Michael-Ainsworth/Teleoperated-Robotic-Arm/3D_Models/Mold-topThermistor.stl

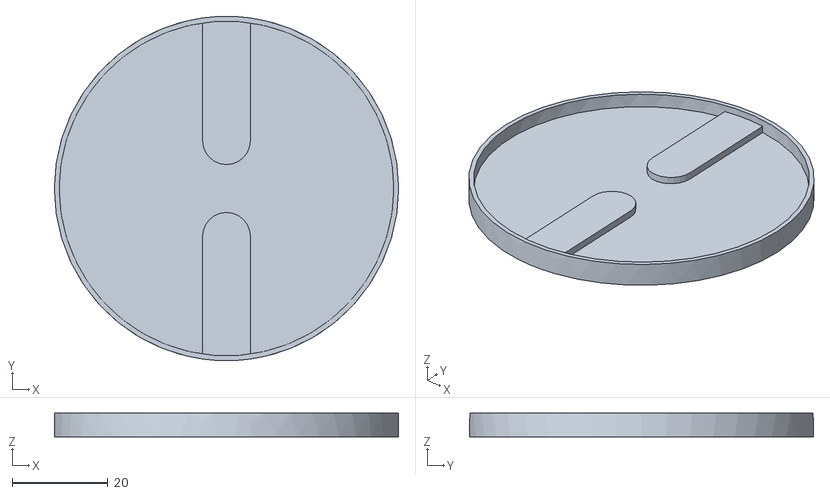
[picture p33: CAD file, 2020-02-25]
3D_Models/Mold-topThermistor.stl
72.0 x 71.9 x 5.00
