Michael-Ainsworth/Teleoperated-Robotic-Arm/3D_Models/Mold-FingerCap.stl

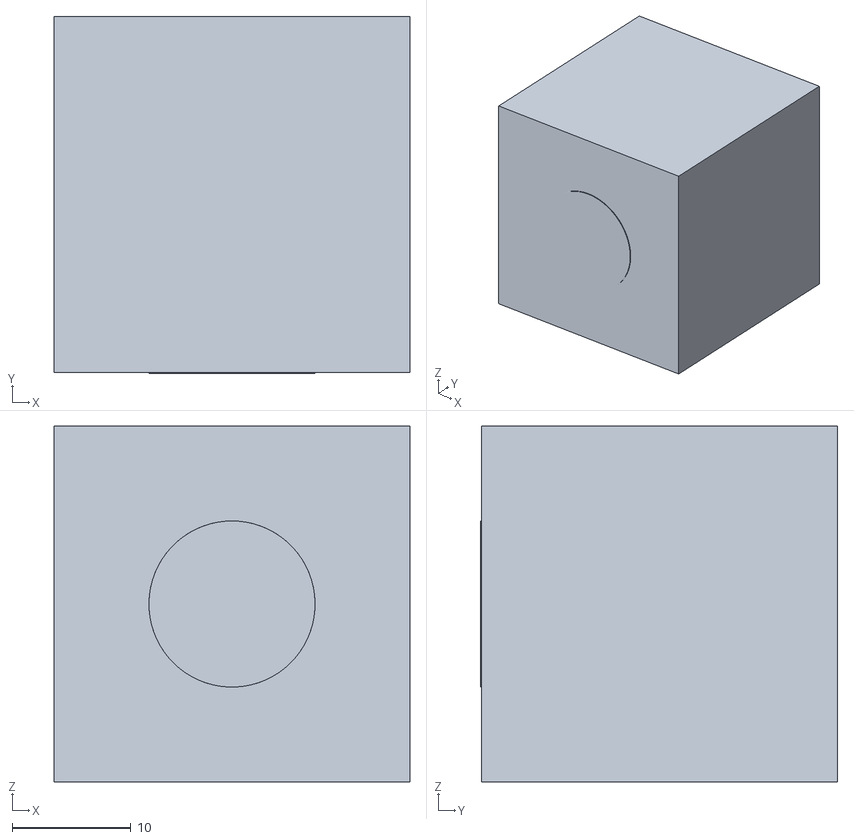
[picture p34: CAD file, 2020-02-25]
3D_Models/Mold-FingerCap.stl
30.0 x 30.1 x 30.0
