Michael-Ainsworth/Teleoperated-Robotic-Arm/3D_Models/Mold-palpatingPuck.stl

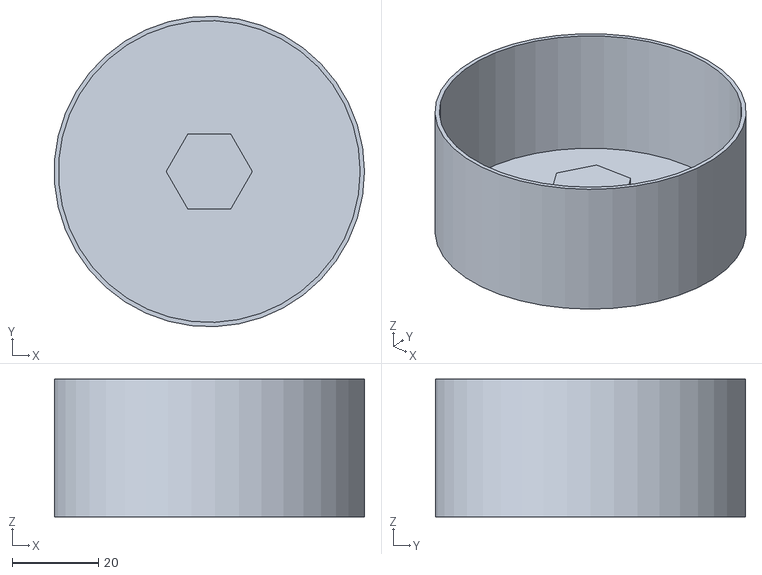
[picture p35: CAD file, 2020-02-25]
3D_Models/Mold-palpatingPuck.stl
71.9 x 71.9 x 32.0
