Michael-Ainsworth/Teleoperated-Robotic-Arm/3D_Models/UR5attachmentHelpingHand.stl

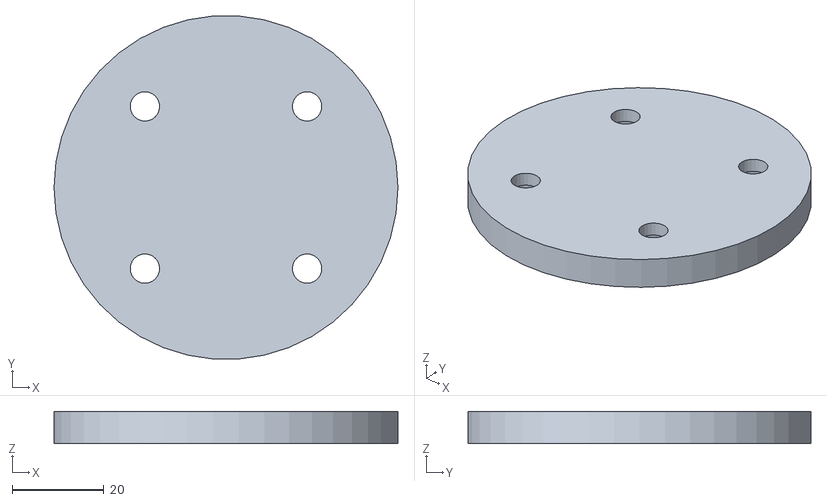
[picture p36: CAD file, 2020-02-25]
3D_Models/UR5attachmentHelpingHand.stl
75.0 x 74.8 x 7.00
