Michael-Ainsworth/Teleoperated-Robotic-Arm/3D_Models/UR5attachmentPalpatingPuck.stl

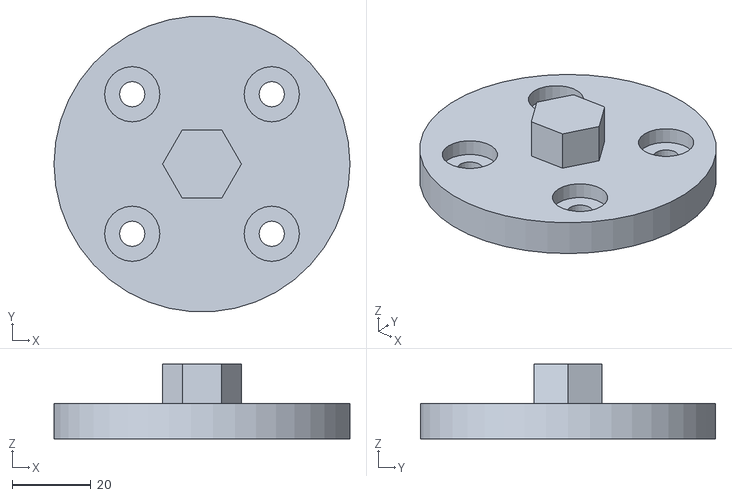
[picture p37: CAD file, 2020-02-25]
3D_Models/UR5attachmentPalpatingPuck.stl
75.0 x 74.8 x 19.0
