Michael-Ainsworth/Teleoperated-Robotic-Arm/3D_Models/DCmotorCasing.stl

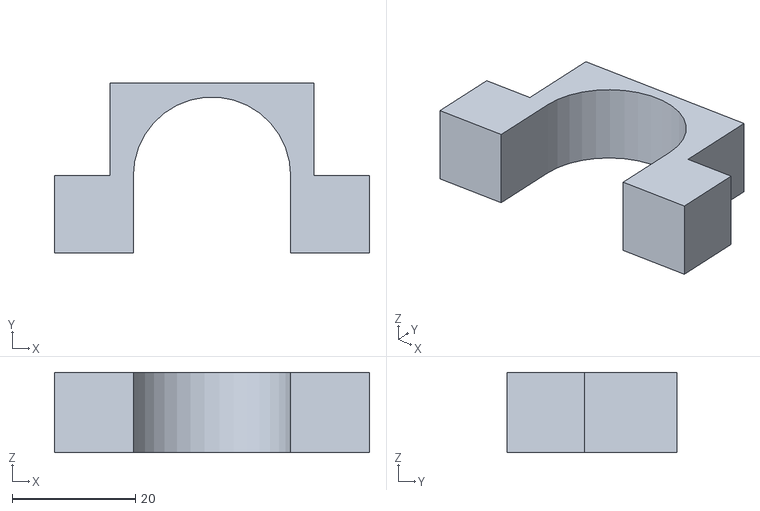
[picture p38: CAD file, 2020-02-25]
3D_Models/DCmotorCasing.stl
51.2 x 27.5 x 13.0
