Michael-Ainsworth/Teleoperated-Robotic-Arm/3D_Models/SpoolForDCmotor.stl

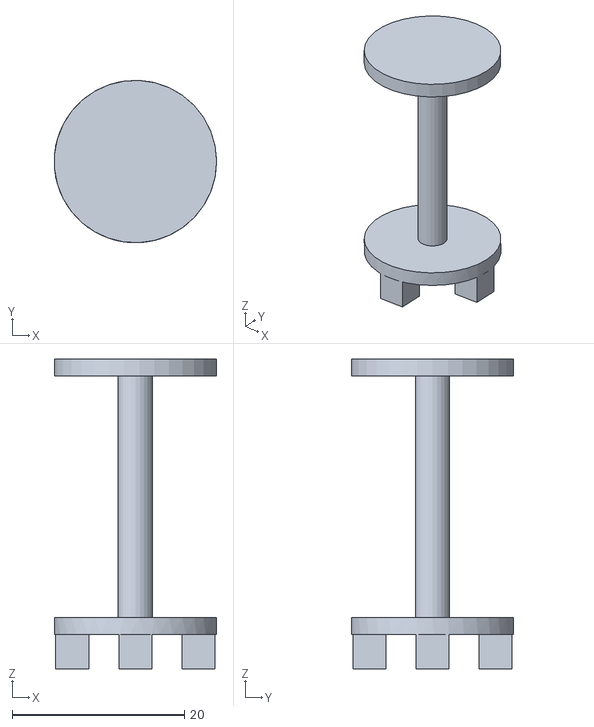
[picture p39: CAD file, 2020-02-25]
3D_Models/SpoolForDCmotor.stl
18.8 x 18.8 x 36.0
