Michael-Ainsworth/Teleoperated-Robotic-Arm/3D_Models/Mold-ThumbCap.stl

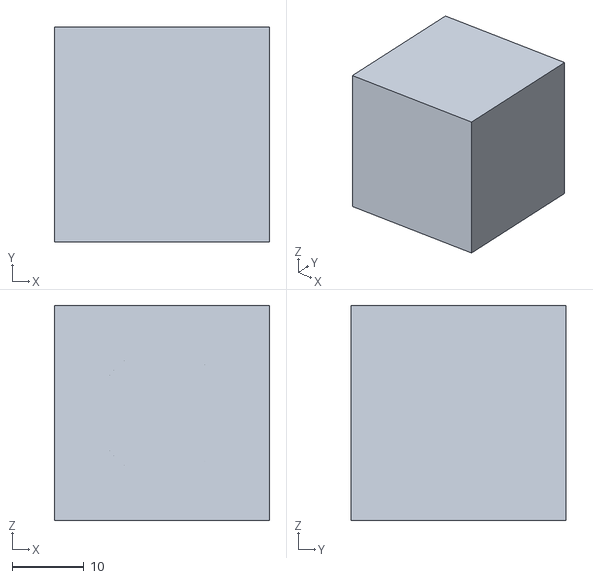
[picture p40: CAD file, 2020-02-25]
3D_Models/Mold-ThumbCap.stl
30.0 x 30.0 x 30.0
