Michael-Ainsworth/Teleoperated-Robotic-Arm/3D_Models/Mold-TopLayerPuck.stl

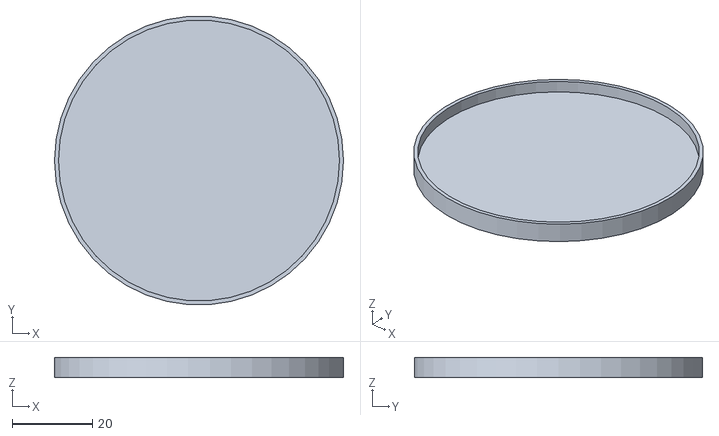
[picture p41: CAD file, 2020-02-25]
3D_Models/Mold-TopLayerPuck.stl
72.0 x 71.8 x 5.00
