Michael-Ainsworth/Teleoperated-Robotic-Arm/(commit log)

2020-02-25 Added STL files
    [DCmotorCasing.stl, Mold-FingerCap.stl, Mold-ThumbCap.stl, Mold-TopLayerPuck.stl, Mold-palpatingPuck.stl, Mold-topThermistor.stl, SpoolForDCmotor.stl, UR5attachmentHelpingHand.stl]
2020-02-25 Add 3D Models Folder
    [DCmotorCasing.stl, Mold-FingerCap.stl, Mold-ThumbCap.stl, Mold-TopLayerPuck.stl, Mold-palpatingPuck.stl, Mold-topThermistor.stl, SpoolForDCmotor.stl, UR5attachmentHelpingHand.stl]
2020-02-26 updated arm tracker code
